lalchandanijatin1-cyber/Robot-arm-/part 5.STEP

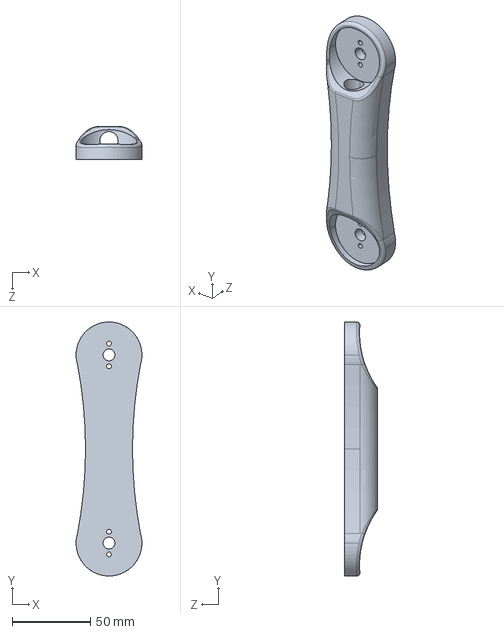
[picture p2: CAD file, 2026-11-03]
part 5.STEP
42.0 x 162.0 x 21.0 mm
