lalchandanijatin1-cyber/Robot-arm-/part 6 (2units).STEP

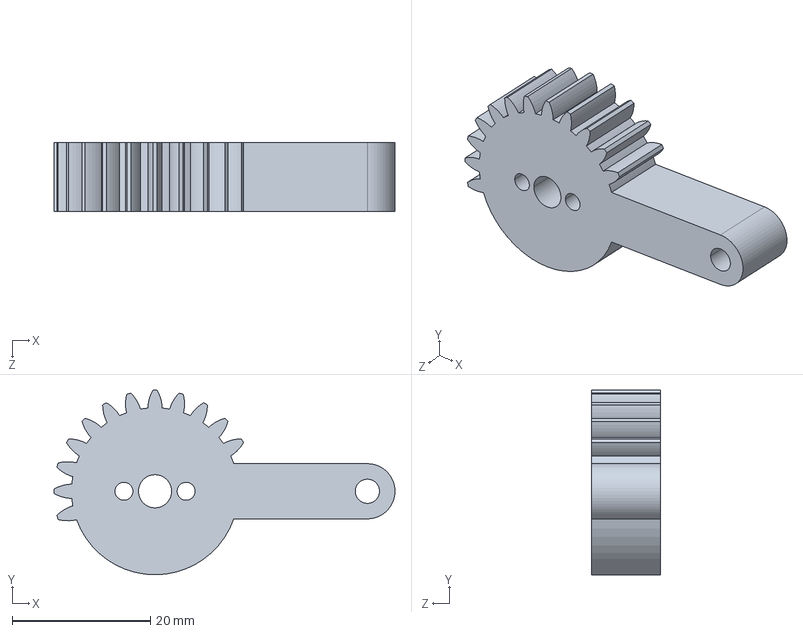
[picture p3: CAD file, 2026-11-03]
part 6 (2units).STEP
49.4 x 26.7 x 10.0 mm
