lalchandanijatin1-cyber/Robot-arm-/part 2.STEP

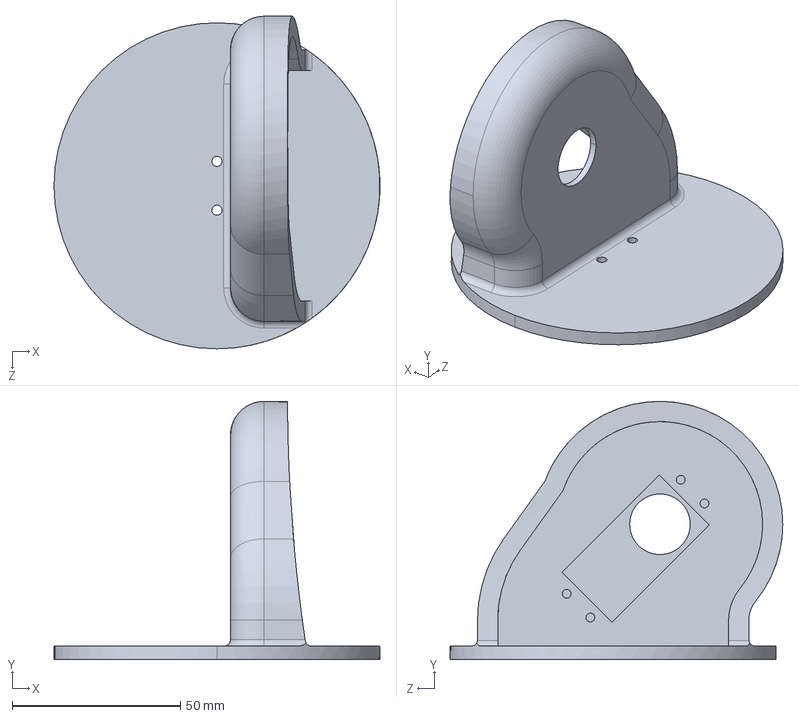
[picture p4: CAD file, 2026-11-03]
part 2.STEP
97.0 x 76.8 x 99.0 mm
