lalchandanijatin1-cyber/Robot-arm-/part 3.STEP

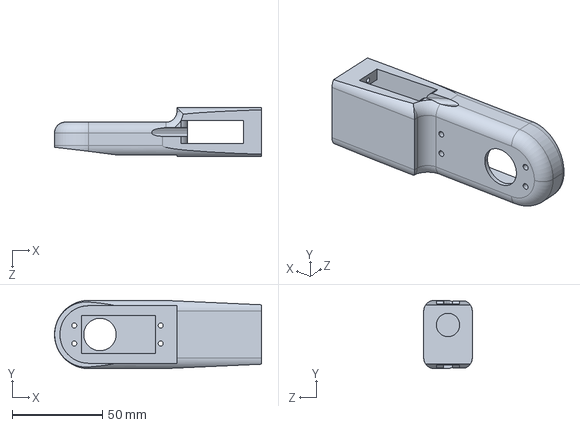
[picture p5: CAD file, 2026-11-03]
part 3.STEP
115.0 x 38.0 x 27.0 mm
