lalchandanijatin1-cyber/Robot-arm-/part 4.STEP

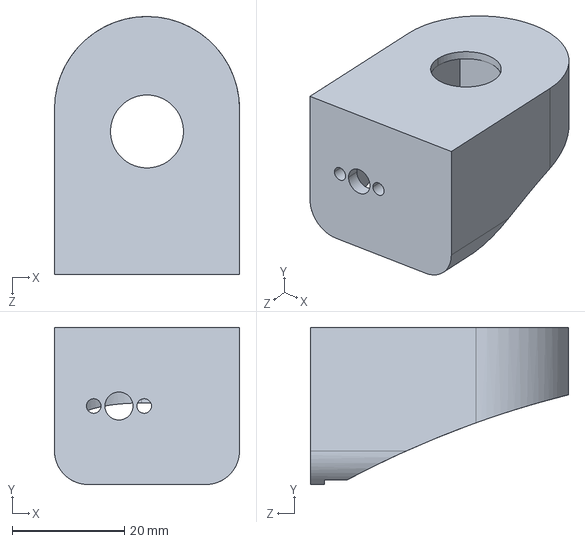
[picture p6: CAD file, 2026-11-03]
part 4.STEP
33.0 x 28.0 x 46.0 mm
