lalchandanijatin1-cyber/Robot-arm-/part 1.STEP

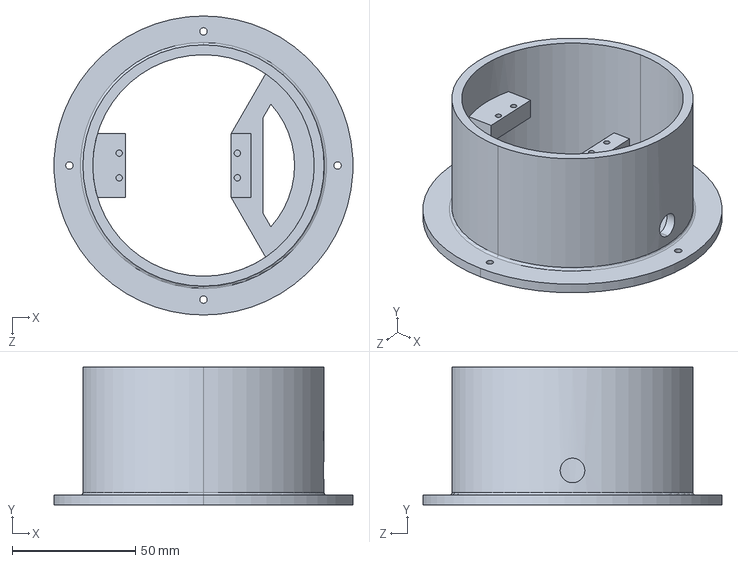
[picture p7: CAD file, 2026-11-03]
part 1.STEP
121.3 x 56.0 x 121.5 mm
