lalchandanijatin1-cyber/Robot-arm-/part 9 (2 units).STEP

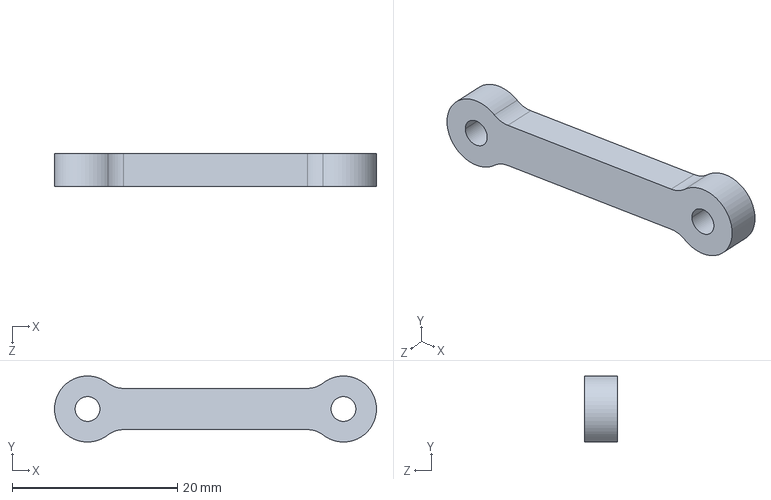
[picture p8: CAD file, 2026-11-03]
part 9 (2 units).STEP
39.0 x 7.99 x 4.00 mm
