lalchandanijatin1-cyber/Robot-arm-/part 8 (2 units).STEP

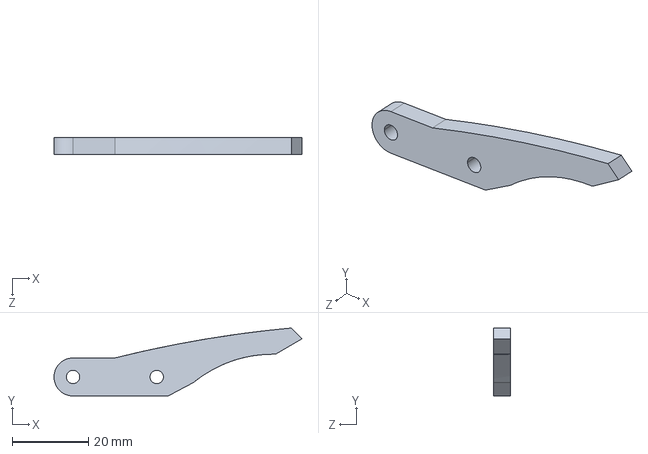
[picture p9: CAD file, 2026-11-03]
part 8 (2 units).STEP
65.2 x 17.9 x 4.50 mm
