lalchandanijatin1-cyber/Robot-arm-/part 7.STEP

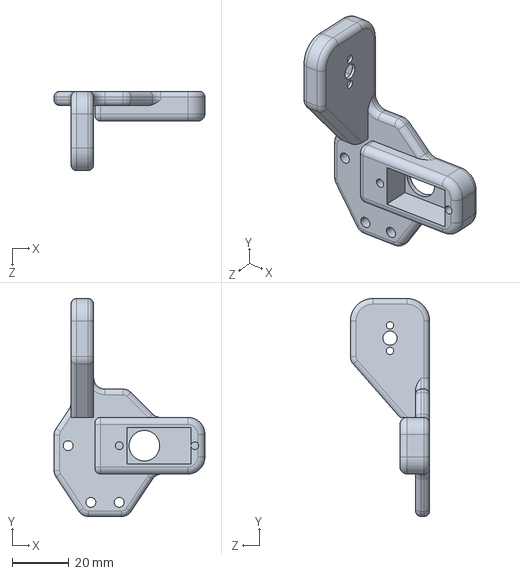
[picture p10: CAD file, 2026-11-03]
part 7.STEP
53.3 x 77.0 x 28.0 mm
